bataseven/Haptic-Device/Desktop App/UI/images/splash.pptx

HAPTIC DEVICE INTERFACE APP

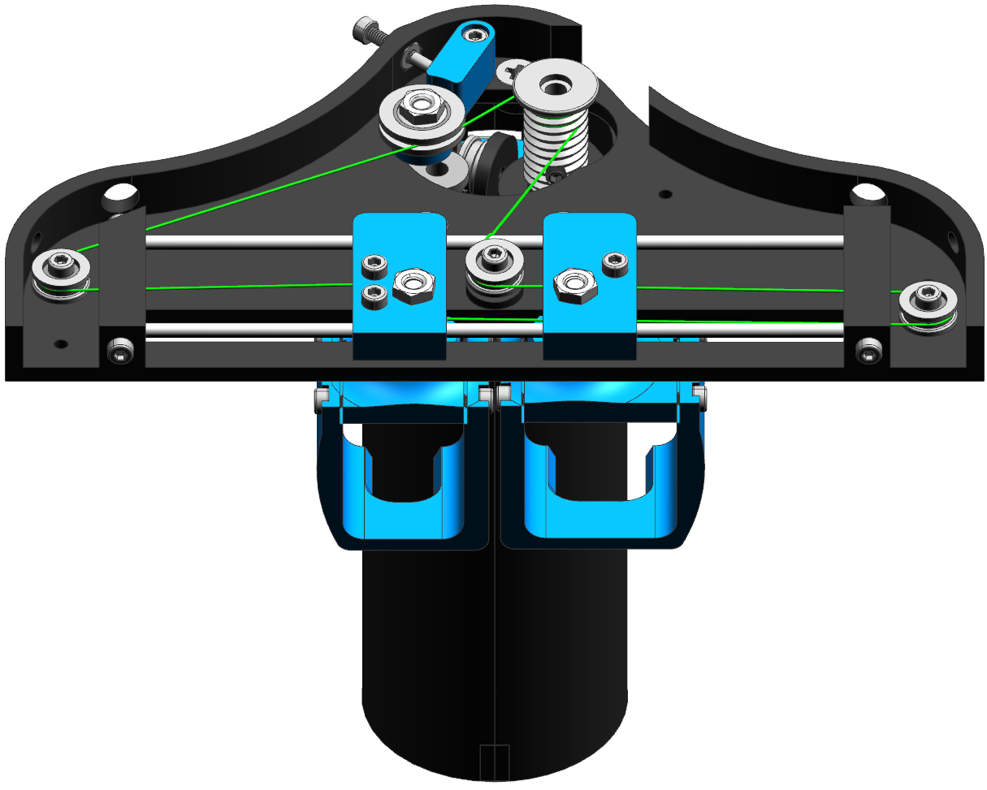
[picture p4: figure]
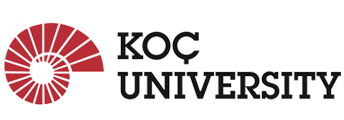
[picture p5: figure]
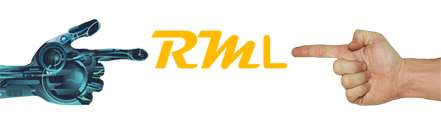
[picture p6: figure]
