bataseven/Haptic-Device/Images/Description1.png

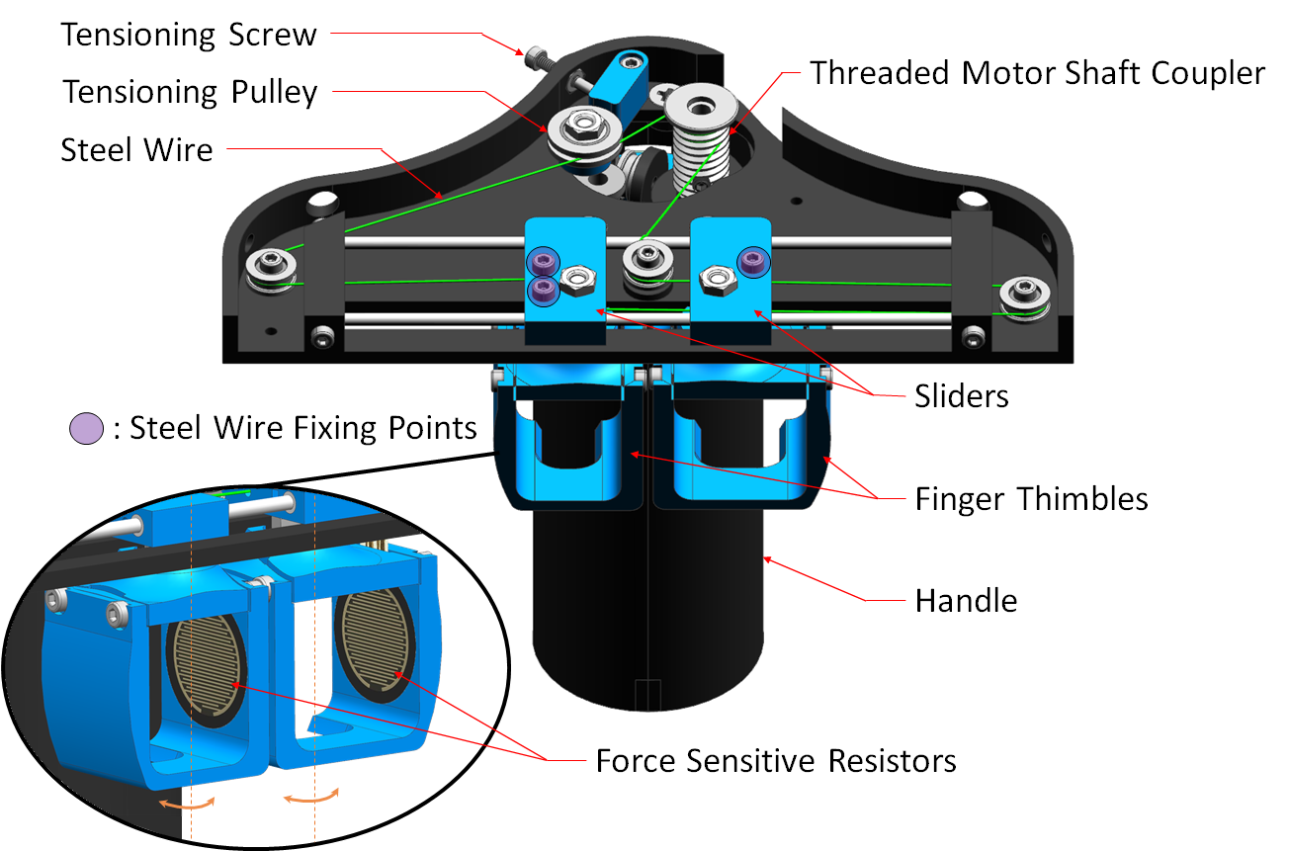
Images/Description1.png
