bataseven/Haptic-Device/Images/Description2.png

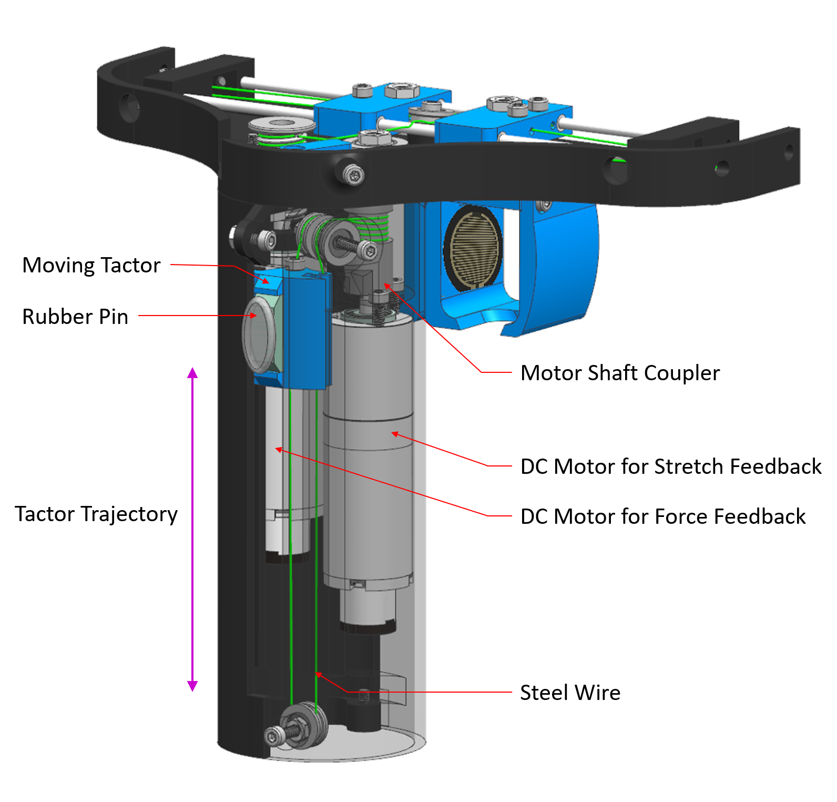
Images/Description2.png
