bataseven/Haptic-Device/Desktop App/requirements-build.txt

# To build the app as a single .exe: pyinstaller HapticDeviceInterface.spec
-r requirements.txt
pyinstaller==6.21.0
