bataseven/Haptic-Device/Microcontroller/src/rainbows.h

/*  OctoWS2811 Rainbow.ino - Rainbow Shifting Test
    http://www.pjrc.com/teensy/td_libs_OctoWS2811.html
    Copyright (c) 2013 Paul Stoffregen, PJRC.COM, LLC

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

  Required Connections
  --------------------
    pin 2:  LED Strip #1    OctoWS2811 drives 8 LED Strips.
    pin 14: LED strip #2    All 8 are the same length.
    pin 7:  LED strip #3
    pin 8:  LED strip #4    A 100 ohm resistor should used
    pin 6:  LED strip #5    between each Teensy pin and the
    pin 20: LED strip #6    wire to the LED strip, to minimize
    pin 21: LED strip #7    high frequency ringining & noise.
    pin 5:  LED strip #8
    pin 15 & 16 - Connect together, but do not use
    pin 4 - Do not use
    pin 3 - Do not use as PWM.  Normal use is ok.
    pin 1 - Output indicating CPU usage, monitor with an oscilloscope,
            logic analyzer or even an LED (brighter = CPU busier)
*/

#include <OctoWS2811.h>

const int ledsPerStrip = 60;

DMAMEM int displayMemory[ledsPerStrip * 6];
int drawingMemory[ledsPerStrip * 6];

const int config = WS2811_GRB | WS2811_800kHz;

OctoWS2811 leds(ledsPerStrip, displayMemory, drawingMemory, config);

int rainbowColors[360];

unsigned int h2rgb(unsigned int v1, unsigned int v2, unsigned int hue) {
    if (hue < 60) return v1 * 60 + (v2 - v1) * hue;
    if (hue < 180) return v2 * 60;
    if (hue < 240) return v1 * 60 + (v2 - v1) * (240 - hue);
    return v1 * 60;
}

// phaseShift is the shift between each row.  phaseShift=0
// causes all rows to show the same colors moving together.
// phaseShift=360 causes each row to be the opposite colors
// as the previous.
//
// cycleTime is the number of milliseconds to shift through
// the entire 360 degrees of the color wheel:
// Red -> Orange -> Yellow -> Green -> Blue -> Violet -> Red
//
void rainbow(int phaseShift, int cycleTime) {
    int color, x, y, wait;

    wait = cycleTime * 1000 / ledsPerStrip;
    for (color = 0; color < 360; color++) {
        digitalWrite(1, HIGH);
        for (x = 0; x < ledsPerStrip; x++) {
            for (y = 0; y < 8; y++) {
                int index = (color + x + y * phaseShift / 2) % 360;
                leds.setPixel(x + y * ledsPerStrip, rainbowColors[index]);
            }
        }
        leds.show();
        digitalWrite(1, LOW);
        delayMicroseconds(wait);
    }
}

// Convert HSL (Hue, Saturation, Lightness) to RGB (Red, Green, Blue)
//
//   hue:        0 to 359 - position on the color wheel, 0=red, 60=orange,
//                            120=yellow, 180=green, 240=blue, 300=violet
//
//   saturation: 0 to 100 - how bright or dull the color, 100=full, 0=gray
//
//   lightness:  0 to 100 - how light the color is, 100=white, 50=color, 0=black
//
int makeColor(unsigned int hue, unsigned int saturation, unsigned int lightness) {
    unsigned int red, green, blue;
    unsigned int var1, var2;

    if (hue > 359) hue = hue % 360;
    if (saturation > 100) saturation = 100;
    if (lightness > 100) lightness = 100;

    // algorithm from: http://www.easyrgb.com/index.php?X=MATH&H=19#text19
    if (saturation == 0) {
        red = green = blue = lightness * 255 / 100;
    } else {
        if (lightness < 50) {
            var2 = lightness * (100 + saturation);
        } else {
            var2 = ((lightness + saturation) * 100) - (saturation * lightness);
        }
        var1 = lightness * 200 - var2;
        red = h2rgb(var1, var2, (hue < 240) ? hue + 120 : hue - 240) * 255 / 600000;
        green = h2rgb(var1, var2, hue) * 255 / 600000;
        blue = h2rgb(var1, var2, (hue >= 120) ? hue - 120 : hue + 240) * 255 / 600000;
    }
    return (red << 16) | (green << 8) | blue;
}

void setup() {
    pinMode(1, OUTPUT);
    digitalWrite(1, HIGH);
    for (int i = 0; i < 360; i++) {
        int hue = i;
        int saturation = 100;
        int lightness = 7;
        // pre-compute the 360 rainbow colors
        rainbowColors[i] = makeColor(hue, saturation, lightness);
    }
    digitalWrite(1, LOW);
    leds.begin();
}

void loop() { rainbow(100, 1000); }

// alternate code:
// http://forum.pjrc.com/threads/16469-looking-for-ideas-on-generating-RGB-colors-from-accelerometer-gyroscope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
