bataseven/Haptic-Device/Desktop App/UI/data_recorder.py

from os.path import dirname, abspath
import time
import re
import os
from PyQt5.QtWidgets import QPushButton, QMessageBox, QLineEdit, QWidget, QFileDialog, QCheckBox, QProgressBar
from PyQt5.QtCore import pyqtSlot, QTimer, Qt, pyqtSignal, QSettings
from PyQt5.QtGui import QIcon, QDoubleValidator
from PyQt5.uic import loadUi  # type: ignore

if __name__ == "__main__":
    from devices import HapticDevice
else:
    from .devices import HapticDevice

# The header and the rows are both built from these lists so that the column names always match the values.
GAIN_COLUMNS = ["PID Position P", "PID Position I", "PID Position D",
                "PID Velocity P", "PID Velocity I", "PID Velocity D",
                "PID Force P", "PID Force I", "PID Force D"]
# (Key in HapticDevice.waveformParams, column name)
WAVE_COLUMNS = [('T', "Wave Type"), ('F', "Wave Frequency"), ('A', "Wave Amplitude"),
                ('O', "Wave Offset"), ('V', "Wave Value")]
FORCE_COLUMNS = ["Thumb Outer Force", "Thumb Inner Force", "Index Inner Force", "Index Outer Force"]
VIRTUAL_OBJECT_COLUMNS = ["Virtual Object Width", "Virtual Object Stiffness", "Virtual Object Damping"]


def motorColumns(motor: str) -> list:
    return [f"{motor} Position", f"{motor} Velocity", f"{motor} Control Mode"] + \
        [f"{motor} {name}" for name in GAIN_COLUMNS] + \
        [f"{motor} {name}" for _, name in WAVE_COLUMNS]


# "Time" is when the app received the values, "Device Time" is when the device read them (seconds since it started).
# "Device Time" is the last column so that the other columns keep their positions from older recordings.
HEADER = ["Data Point", "Time"] + motorColumns("Finger") + motorColumns("Palm") + FORCE_COLUMNS + ["Device Time"]
SEPARATOR = ", "


class DataRecorder(QWidget):
    recordingInProgress = pyqtSignal(bool)

    def __init__(self, hapticDevice: HapticDevice, portName: str, parent=None) -> None:
        super().__init__(parent=parent)
        loadUi(dirname(abspath(__file__)) + "/data_recorder.ui", self)
        self.savePathEdit: QLineEdit
        self.browseButton: QPushButton
        self.filePrefixEdit: QLineEdit
        self.virtualObjectCheckBox: QCheckBox
        self.saveDurationEdit: QLineEdit
        self.continuousCheckBox: QCheckBox
        self.progressBar: QProgressBar
        self.recordButton: QPushButton
        self.hapticDevice = hapticDevice
        self.portName: str = portName
        self.dataPoints = 0
        self.recordVirtualObject = True
        self.setupUI()

        self.recordTimer = QTimer()
        self.recordTimer.timeout.connect(self.stopRecording)
        self.progressBarTimer = QTimer()
        self.progressBarTimer.timeout.connect(self.updateProgressBar)
        self.isRecording = False

    def setupUI(self):
        iconPath = dirname(abspath(__file__)) + "/images/assembled.png"
        self.icon = QIcon(iconPath)
        self.setWindowIcon(self.icon)
        self.setWindowTitle("Data Recorder")
        self.browseButton.clicked.connect(self.browse)
        self.recordButton.clicked.connect(self.record)
        self.continuousCheckBox.stateChanged.connect(
            lambda state: self.saveDurationEdit.setEnabled(state != Qt.Checked))
        self.savePathEdit.setText(os.getcwd())
        validator = QDoubleValidator(
            self, bottom=0.0, top=86400.0, notation=QDoubleValidator.StandardNotation)
        self.saveDurationEdit.setValidator(validator)
        # Make the widget window size unchangeable
        self.setFixedSize(self.size())

    def record(self):
        if not self.isRecording:
            self.startRecording()
        else:
            self.stopRecording()

    def startRecording(self):
        if self.isRecording:
            return
        durationText = self.saveDurationEdit.text().strip()
        isContinuous = self.continuousCheckBox.isChecked() or durationText == "0"
        duration = 0.0
        if not isContinuous:
            try:
                duration = float(durationText)
            except ValueError:
                duration = 0.0
            if duration <= 0:
                QMessageBox.warning(self, "Data Recorder", "Enter the recording duration in seconds.")
                return

        self.recordVirtualObject = self.virtualObjectCheckBox.isChecked()
        header = HEADER + (VIRTUAL_OBJECT_COLUMNS if self.recordVirtualObject else [])
        rawPrefix = self.filePrefixEdit.text().strip()
        safePrefix = re.sub(r'[<>:"/\\|?*]', '_', rawPrefix)
        prefixPart = f"{safePrefix}_" if safePrefix else ""

        try:
            # Include current date in the file name
            self.fileName = f"HapticDeviceData_{prefixPart}{self.portName}_{time.strftime('%Y-%m-%d_%H-%M-%S')}.csv"
            self.fullPath = os.path.join(self.savePathEdit.text(), self.fileName)
            with open(self.fullPath, "w") as file:
                file.write(SEPARATOR.join(header) + "\n")
        except OSError as e:
            QMessageBox.warning(self, "Data Recorder", f"Could not create the recording file:\n{e}")
            return

        self.dataPoints = 0
        # Deactivate input widgets while recording
        self.browseButton.setEnabled(False)
        self.saveDurationEdit.setEnabled(False)
        self.savePathEdit.setEnabled(False)
        self.filePrefixEdit.setEnabled(False)
        self.virtualObjectCheckBox.setEnabled(False)
        self.continuousCheckBox.setEnabled(False)
        self.recordButton.setText("Stop")

        if isContinuous:
            self.progressBar.setRange(0, 0)
        else:
            self.progressBar.setRange(0, 100)
            self.recordTimer.start(int(duration * 1000))
            self.progressBarTimer.start(100)

        self.isRecording = True
        self.recordingInProgress.emit(self.isRecording)

    def stopRecording(self):
        if not self.isRecording:
            return

        self.browseButton.setEnabled(True)
        self.saveDurationEdit.setEnabled(not self.continuousCheckBox.isChecked())
        self.savePathEdit.setEnabled(True)
        self.filePrefixEdit.setEnabled(True)
        self.virtualObjectCheckBox.setEnabled(True)
        self.continuousCheckBox.setEnabled(True)
        self.recordButton.setText("Record")

        # Stop the timer if it is running
        if self.recordTimer.isActive():
            self.recordTimer.stop()
        if self.progressBarTimer.isActive():
            self.progressBarTimer.stop()
        self.progressBar.setRange(0, 100)
        self.progressBar.setValue(0)

        self.isRecording = False
        self.recordingInProgress.emit(self.isRecording)

        # Pop a message box to inform the user that the recording is done
        dialog = QMessageBox(parent=None)
        dialog.setText(
            f"{self.dataPoints} data point" + ("" if self.dataPoints == 1 else "s") + f" saved to {self.fullPath}")
        dialog.setWindowTitle("Recording done")
        dialog.setWindowIcon(self.windowIcon())
        dialog.setStandardButtons(QMessageBox.Ok)
        dialog.setIcon(QMessageBox.Information)
        dialog.exec_()

    @pyqtSlot(bool)
    def onSerialConnected(self, connected: bool):
        if not connected:
            self.stopRecording()
        self.recordButton.setEnabled(connected)

    @pyqtSlot()
    def appendToFile(self):
        if not self.isRecording:
            return

        # The current time includes the transfer and processing delays. Use the "Device Time" column for exact intervals.
        currentTime = time.time()
        device = self.hapticDevice
        values = [self.dataPoints, f"{currentTime:.3f}"]
        values += [device.fingerPos, device.fingerVel, device.fingerControlMode, *device.fingerGains]
        values += [device.waveformParams[0][key] for key, _ in WAVE_COLUMNS]
        values += [device.palmPos, device.palmVel, device.palmControlMode, *device.palmGains]
        values += [device.waveformParams[1][key] for key, _ in WAVE_COLUMNS]
        values += device.forceValues
        values.append(f"{device.deviceTime:.6f}")
        if self.recordVirtualObject:
            values += [device.pseudoObject['width'], device.pseudoObject['stiffness'], device.pseudoObject['damping']]

        try:
            with open(self.fullPath, "a") as file:
                file.write(SEPARATOR.join(str(value) for value in values) + "\n")
        except OSError as e:  # e.g. the drive was removed
            self.stopRecording()
            QMessageBox.warning(self, "Data Recorder", f"Recording stopped. Could not write to the file:\n{e}")
            return

        self.dataPoints += 1

    def updateProgressBar(self):
        progress = (self.recordTimer.interval(
        ) - self.recordTimer.remainingTime()) / self.recordTimer.interval() * 100
        self.progressBar.setValue(int(progress))
        self.progressBarTimer.start(100)

    def browse(self):
        path = QFileDialog.getExistingDirectory(self, "Select Directory")
        if path != "":
            self.savePathEdit.setText(path)

    def loadSettings(self, settings: QSettings) -> None:
        savePath = settings.value("recorder/savePath", None)
        if savePath and os.path.isdir(str(savePath)):
            self.savePathEdit.setText(str(savePath))
        duration = settings.value("recorder/duration", None)
        if duration is not None:
            self.saveDurationEdit.setText(str(duration))
        prefix = settings.value("recorder/filePrefix", None)
        if prefix is not None:
            self.filePrefixEdit.setText(str(prefix))
        continuous = settings.value("recorder/continuous", None)
        if continuous is not None:
            self.continuousCheckBox.setChecked(str(continuous).lower() == "true")
        virtualObject = settings.value("recorder/virtualObject", None)
        if virtualObject is not None:
            self.virtualObjectCheckBox.setChecked(str(virtualObject).lower() == "true")

    def saveSettings(self, settings: QSettings) -> None:
        settings.setValue("recorder/savePath", self.savePathEdit.text())
        settings.setValue("recorder/duration", self.saveDurationEdit.text())
        settings.setValue("recorder/filePrefix", self.filePrefixEdit.text())
        settings.setValue("recorder/continuous", self.continuousCheckBox.isChecked())
        settings.setValue("recorder/virtualObject", self.virtualObjectCheckBox.isChecked())

    def closeEvent(self, event):
        self.stopRecording()
        event.accept()


if __name__ == "__main__":
    import sys
    from PyQt5.QtWidgets import QApplication
    app = QApplication(sys.argv)
    window = DataRecorder(None, "COM3")
    window.show()
    sys.exit(app.exec_())
