bataseven/Haptic-Device/(commit log)

2026-10-27 Fix PID math, gain handling and waveform continuity in the firmware
    - Store the PID integral term and previous error as double. They were
    integers, so in force control (errors below 1 N) the derivative term
    acted as an extra proportional term and the integral term dropped
    every fraction. The gains were tuned with this behavior and need
    re-tuning.
    - The 1 kHz loop no longer overwrites the finger force Kp. The lower
    gain during contact is applied with a scale factor, so a Kp sent over
    serial is kept.
    - printGains() reads the gains per mode instead of switching the live
    controller mode, which could run the control loop with the wrong
    controller for one tick.
    - resetEncoderPos()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
2026-10-27 Harden firmware message parsing and stop the motors if the app stops
    Parsing:
    - Check every number in a message before using it. A missing field
    passed NULL to atof() and crashed the Teensy.
    - Read the controller mode as a digit instead of atoi() on a single char,
    and reject out-of-range modes, wave types and program ids.
    - Apply gain, mode and virtual object changes with interrupts disabled,
    so the 1 kHz control loop never sees half of a change.
    Host timeout:
    - New "T<ms>" message arms a timeout ("T0" disarms). If no message
    arrives within it, the motors are released, the waveforms and virtual
    object are cleared, the LED turns purple and "<X...>" is sent. The
    next message of an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
2026-10-27 Make the desktop app robust and sync controller modes from the device
    - Use the serial port only from the GUI thread. It was created in the
    GUI thread but read in a worker thread while being written and closed
    from the GUI thread. QSerialPort reads asynchronously, so the thread
    wasn't needed.
    - Show unhandled exceptions in a dialog instead of letting PyQt end the
    app silently. Each distinct error is shown once.
    - Recorder: warn about an empty or zero duration instead of crashing,
    and stop connecting the stop timer again on every start.
    - Decode serial bytes with errors="replace", so a corrupted byte no
    longer raises.
    - Closing the Settings window called serialConnected.disconnect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
2026-10-27 Clean up the repository and document setup and the serial protocol
    Removed:
    - Old recordings in "Useless Data", the "tbd" log file, the Simulink
    cache (slprj/, model1.slxc) and splash.pptx.
    - Dead code: test.py, collapsible_box.py, data_recorder(Advanced).ui and
    the "Save To EEPROM" button that only said it wasn't implemented.
    - The 6 unused stylesheet themes and the PyQt4/PySide loader that
    needed qdarkstyle. Only DarkOrange is used.
    - 527 generated ROS message headers. Only wsg_50_common is not in the
    rosserial library from lib_deps; the ENABLE_ROS build still compiles.
    - PySide6 and qdarkstyle from requirements.txt; neither was imported.
    Changed:
    - The device sends its encoder co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
2026-10-27 Record the device time of each status update
    The firmware starts each status line to the desktop app with an "R"
    message: micros() at the moment the values were read. The app converts
    it to seconds since the device started, handling the overflow every
    71.6 minutes and device restarts, and the recorder writes it to a new
    "Device Time" column. The existing "Time" column is the PC receive time,
    which includes USB and processing delays.
    "Device Time" is the last column so the other columns keep their
    positions. fix_recording_headers.py skips files that have it.
2026-10-27 Plot live data with pyqtgraph instead of matplotlib
    The Animator window is rebuilt with pyqtgraph, which redraws much
    faster, so the default update interval is 50 ms instead of 250 ms. It
    keeps the per-value check boxes, pause button, update interval slider
    and Y auto-scaling. Zooming, panning and exporting are in pyqtgraph's
    mouse controls and right-click menu, instead of the matplotlib toolbar.
    Hidden values are also removed from the legend.
    requirements.txt: add pyqtgraph 0.13.7. matplotlib is now only used by
    the standalone UI/serial_animator.py; pin it to 3.10.0, which works
    with numpy 2 (3.7.2 doesn't).
2026-10-27 Add unit tests for the firmware and the desktop app
    Firmware (pio test -e native, needs gcc, e.g. on Linux or WSL):
    - test_waveform: wave shapes, no jump when the frequency changes or
    micros() overflows.
    - test_motor: PID derivative and integral with errors below 1, force Kp
    scale, per-mode gains, velocity, no velocity jump when the encoder
    position is set or reset, acceleration needs 5 positions.
    - test_pressure_sensor: calibration when the sensor reads 0, startup
    force becomes the zero.
    - test/native_stubs stands in for the Arduino core and the Encoder
    library. default_envs keeps "pio run" building only the Teensy, and
    the Teensy env ignores the tests.
    - WaveformGenerator keeps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
2026-10-27 Add a GitHub Actions workflow and a PyInstaller build of the app
    - .github/workflows/tests.yml runs on every push and pull request:
    - Ubuntu: firmware unit tests (pio test -e native) and the Teensy
    build.
    - Windows: desktop app unit tests, then builds
    HapticDeviceInterface.exe with PyInstaller and uploads it as an
    artifact.
    - HapticDeviceInterface.spec builds a single windowed .exe (~50 MB) with
    the .ui files and images. requirements-build.txt adds PyInstaller
    6.21.0; 6.11 could not load numpy 2.4 in the .exe. numpy is pinned to
    2.4.4 so builds are reproducible.
    - app.pyw also writes errors to the log file when it has no console, as
    in the windowed .exe.
    - README: lin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
2026-10-27 Fix the native firmware tests in CI
    PlatformIO skipped the libraries in lib/ for the native environment,
    because they have no manifest and the native platform has no Arduino
    framework, so the tests couldn't find their headers. lib_compat_mode =
    off includes them. Tested with PlatformIO 6.2.0 on Ubuntu: 17 passed.
    Also move actions/checkout and actions/setup-python to the versions
    that run on Node.js 24.
2026-10-27 Pin PyQt5 to 5.15.9
    pyqt5-tools and pyqt5-plugins, which provide Qt Designer for editing the
    .ui files, require exactly PyQt5 5.15.9. 5.15.10 made pip report a
    conflict with them.
2026-10-27 Show port descriptions, select the Teensy, and fix theme image warnings
    - The port list shows each port's description, e.g. "COM6 (Standard
    Serial over Bluetooth link)", and "Teensy" for the device. The device
    is selected as soon as it is plugged in.
    - While a port opens, the button says "Connecting..." with a busy
    cursor. Opening a Bluetooth port whose device is not reachable takes a
    few seconds on Windows. If it fails, a message says which port to pick.
    - Remove the printer ICC profiles from two theme images and recompile the
    theme resources. Qt could not read them and printed "Failed to parse
    ICC profile" warnings at startup.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
2026-10-28 Give the rigid-body hold its own controller and fix steady-state detection
    - The finger was held at a rigid object by switching to position control
    and back on every 1 ms tick. Each switch reset the controller, so the
    derivative used a previous error of 0 and acted as extra P gain, and the
    steady-state window was cleared. holdPosition() now has its own gains and
    state. RIGID_BODY_KP = 7 (position Kp + Kd) keeps today's wall stiffness.
    - Steady state is only checked once the 20-error window is full.
    - No derivative spike on the first step after a controller reset.
    - Serial: read all available bytes per loop() and drop overflowed messages.
    - setResolutionBit sets maxPulse to 2^n - 1, n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
2026-10-28 Fix app edge cases and remove the dead scripts
    - Wave parameters: refuse a mm conversion factor of 0 instead of raising,
    and always store numbers (whole numbers as int).
    - Data recorder: show a warning when the file cannot be created or written,
    instead of print(), which the .exe does not show.
    - Find the serial messages once per line, with the start and end characters
    escaped. They are read-only in the settings now, because the firmware
    cannot change them.
    - Remove the 250 ms nested event loop on disconnect. The worker has already
    sent T0/C0 and closed the port by then.
    - Reuse the recording icon timer instead of creating one per recording.
    - Delete UI/serial_animator.py (replaced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
2026-10-28 Reset the rigid-body hold in the brake zone and fix the settings tooltips
    - A hold that starts again after the proximity brake used the previous
    hold's error for its derivative. No effect while RIGID_BODY_KD is 0.
    - The "set by the firmware" tooltips were overwritten by the old ones.
    The note is now added to the old tooltips.
2026-10-28 Bump the app version to 2.0.0
    It needs the new firmware (heartbeat, host timeout, device time and unit
    messages) and writes a different recording header.
2026-10-28 Open the serial port without freezing the window
    Opening an unreachable Bluetooth serial port takes about 13 s on Windows,
    and the window froze the whole time.
    - The serial worker runs in its own QThread. The GUI talks to it only
    through signals, and shutdown() closes the port and stops the thread
    when the app closes.
    - That alone was not enough: QSerialPort.open() keeps Python's GIL while
    it waits, which stops every Python thread. The worker first tries the
    port with CreateFileW through ctypes, which releases the GIL, and only
    calls QSerialPort.open() if that works.
    Measured on COM6 (Bluetooth, device off): the GUI's longest pause went
    from 12.8 s to 73 ms. A Bluetooth port whos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
2026-10-28 Keep the connect button disabled while connecting
    The port refresh timer enabled the button and the port list every few
    seconds, so they could be clicked while the worker was still opening the
    port. The refresh stops while connecting and starts again if the open
    fails.
2026-10-28 Keep the connect button disabled when the ports are refreshed while connecting
    Clicking "refresh available serial ports" while a port was opening
    enabled the connect button and the port list again. The refresh leaves
    them alone while connecting, and the refresh button is disabled until the
    worker reports the result.
2026-10-29 Home the finger and the palm with limit switches on a shared pin
    The finger and palm limit switches are wired in parallel to pin 2. Only one
    motor homes at a time, and the other motor is braked and not controlled
    until it finishes, so every press belongs to the homing motor. Outside
    homing, the press is attributed to the motor moving toward its switch.
    The palm homes at power on, then the finger. If the switch does not
    release, the other motor backs off its switch for at most 500 ms; if it
    still does not release or a motor reaches its opposite limit, homing gives
    up, the LED turns red and the device sends Z. The desktop app shows it.
    The palm button no longer calls home() from the control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
