bataseven/Haptic-Device/(notices)

Notices in the files:
Desktop App/UI/main_window.py:
font-weight:normal;\">© Koc University, Robotics and Mechatronics Laboratory
